openpnp/openpnp-openbuilds/Images/overview_front.jpg

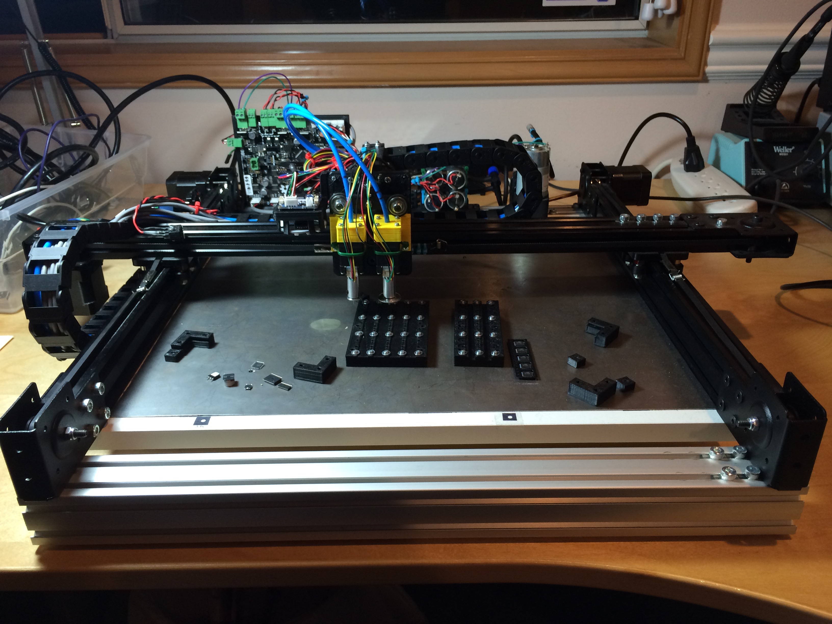
Images/overview_front.jpg
