openpnp/openpnp-openbuilds/Images/overview_top.jpg

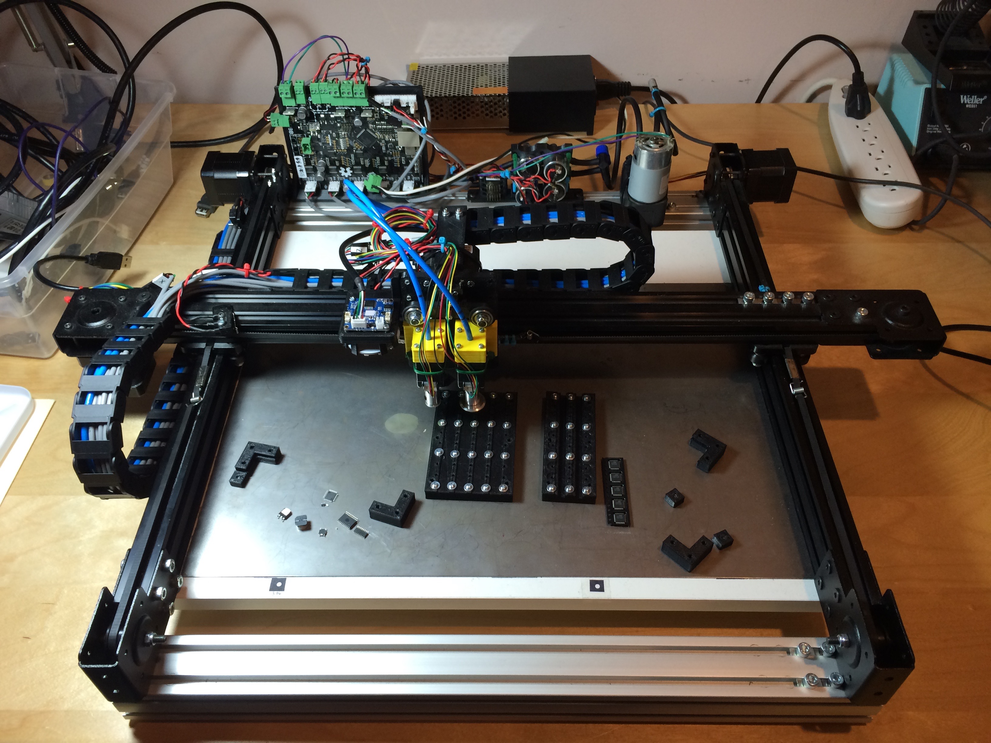
Images/overview_top.jpg
