openpnp/openpnp-openbuilds/Images/camera_closeup.jpg

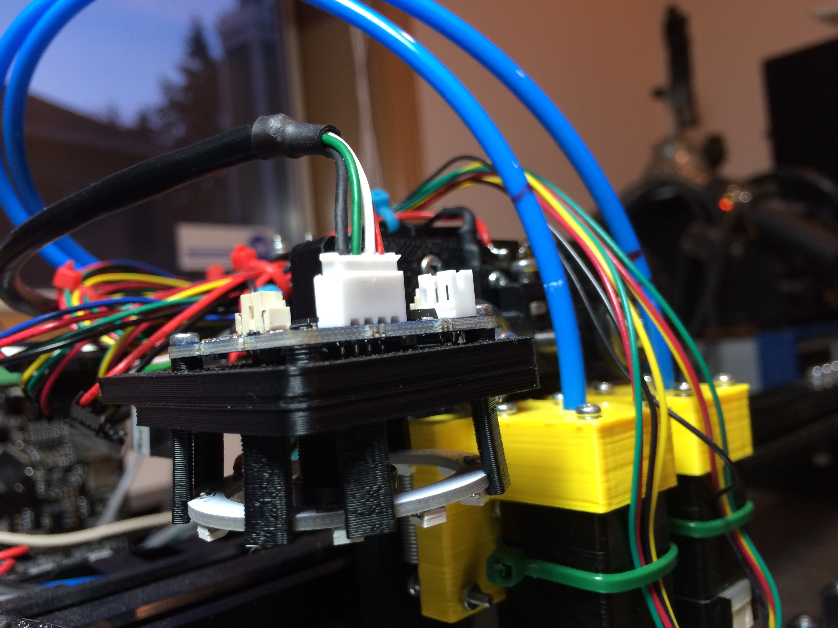
Images/camera_closeup.jpg
