openpnp/openpnp-openbuilds/Images/Electronics and Plumbing.png

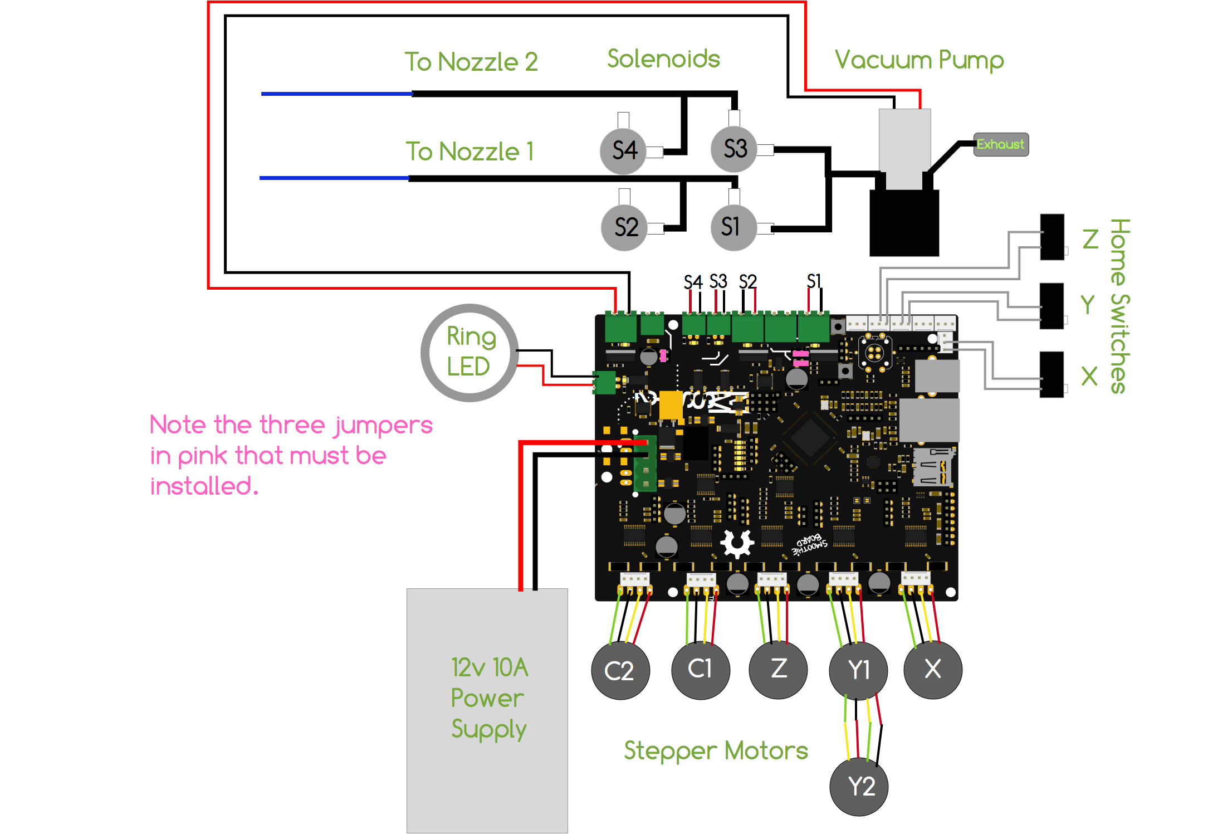
Images/Electronics and Plumbing.png
