openpnp/openpnp-openbuilds/Images/head_closeup.jpg

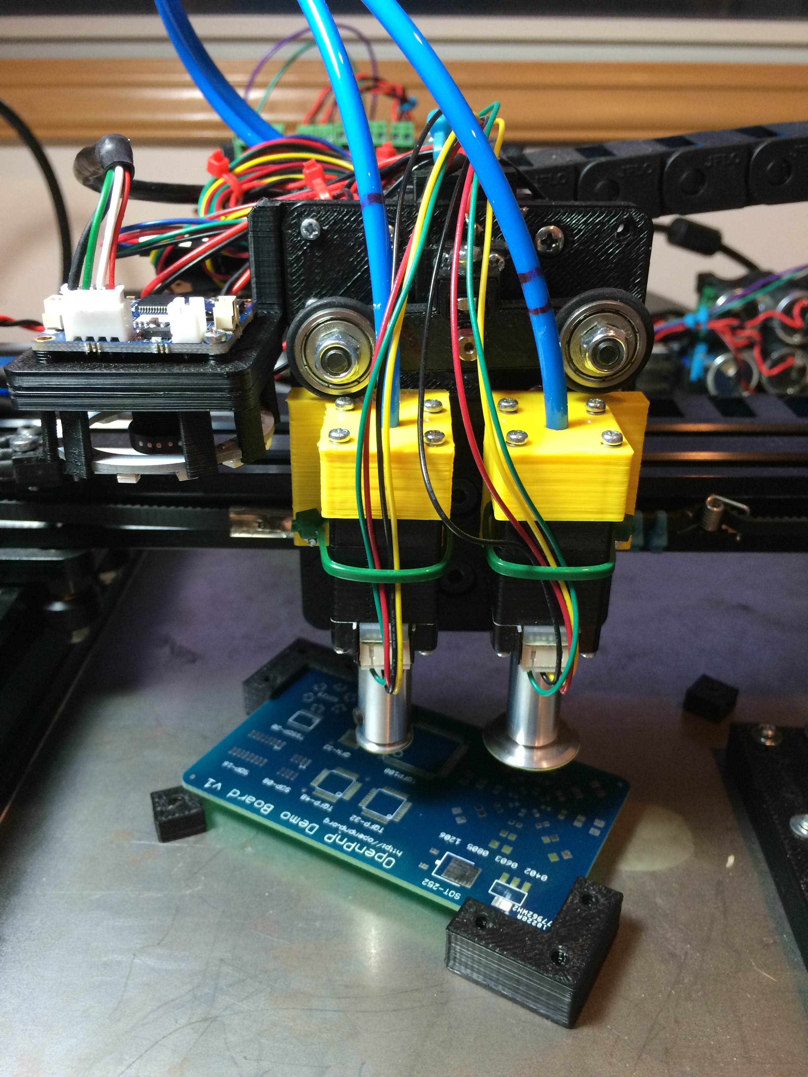
Images/head_closeup.jpg
