openpnp/openpnp-openbuilds/Images/plumbing_detail.jpg

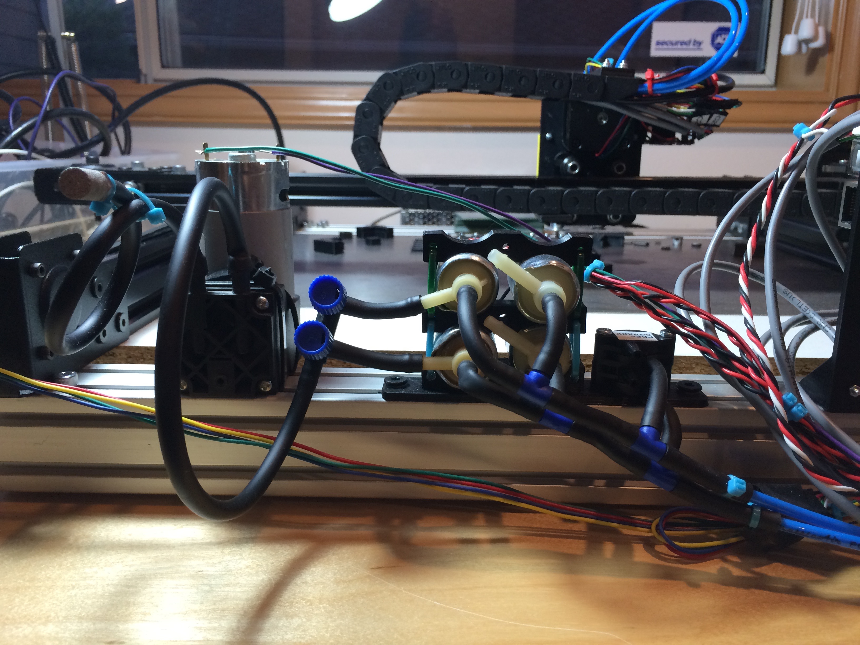
Images/plumbing_detail.jpg
