openpnp/openpnp-openbuilds/Images/pump_diode.jpg

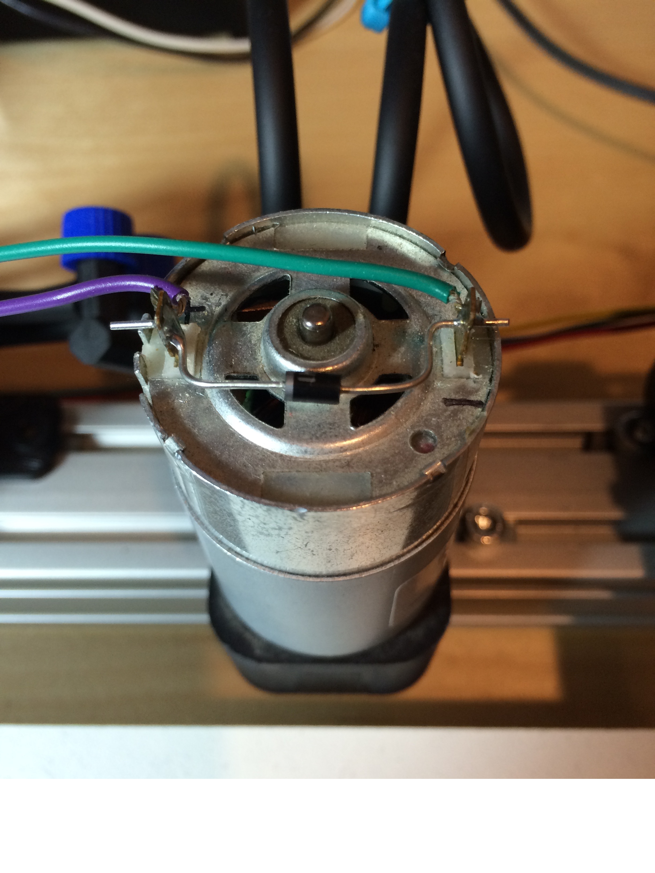
Images/pump_diode.jpg
