openpnp/openpnp-openbuilds/Images/smoothie_jumpers.jpg

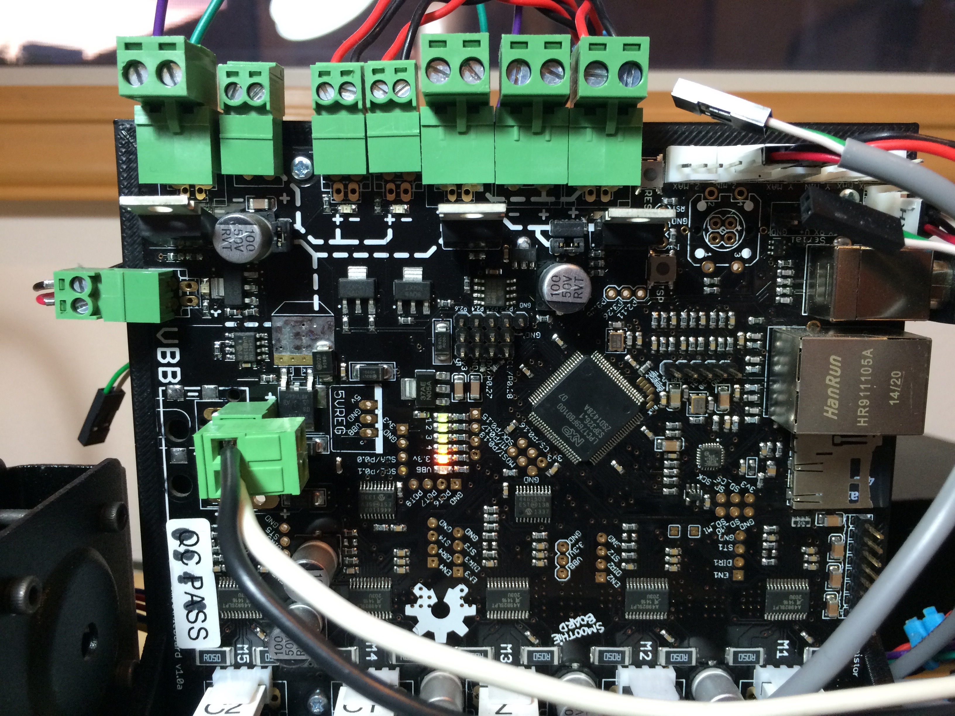
Images/smoothie_jumpers.jpg
