openpnp/openpnp-openbuilds/Images/solenoid_detail.jpg

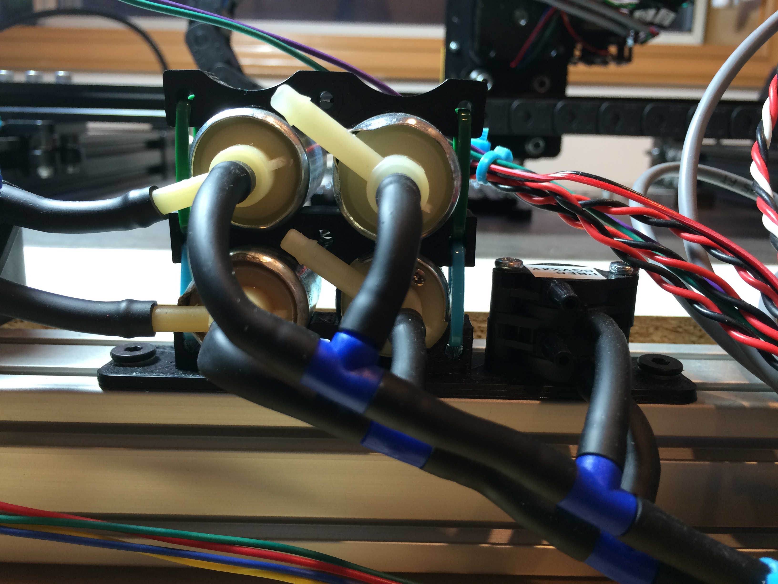
Images/solenoid_detail.jpg
