openpnp/openpnp-openbuilds/Images/solenoid_diodes.jpg

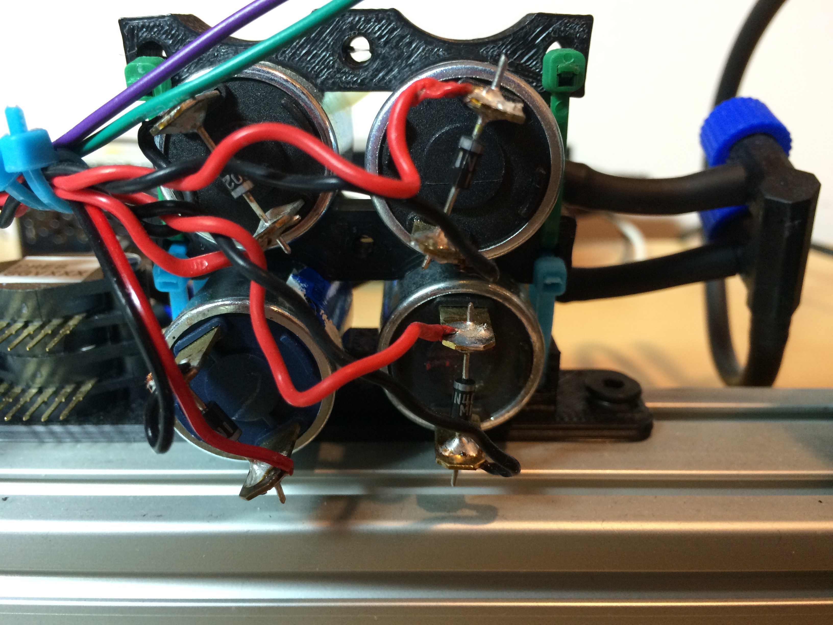
Images/solenoid_diodes.jpg
