openpnp/openpnp-openbuilds/Images/x_y_home_switch_locations.jpg

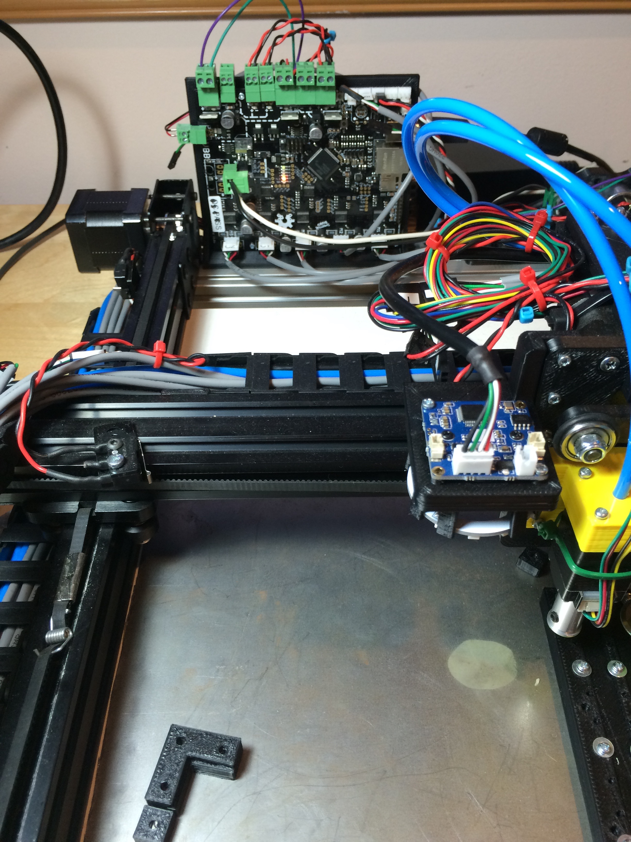
Images/x_y_home_switch_locations.jpg
