openpnp/openpnp-openbuilds/Images/z_detail.jpg

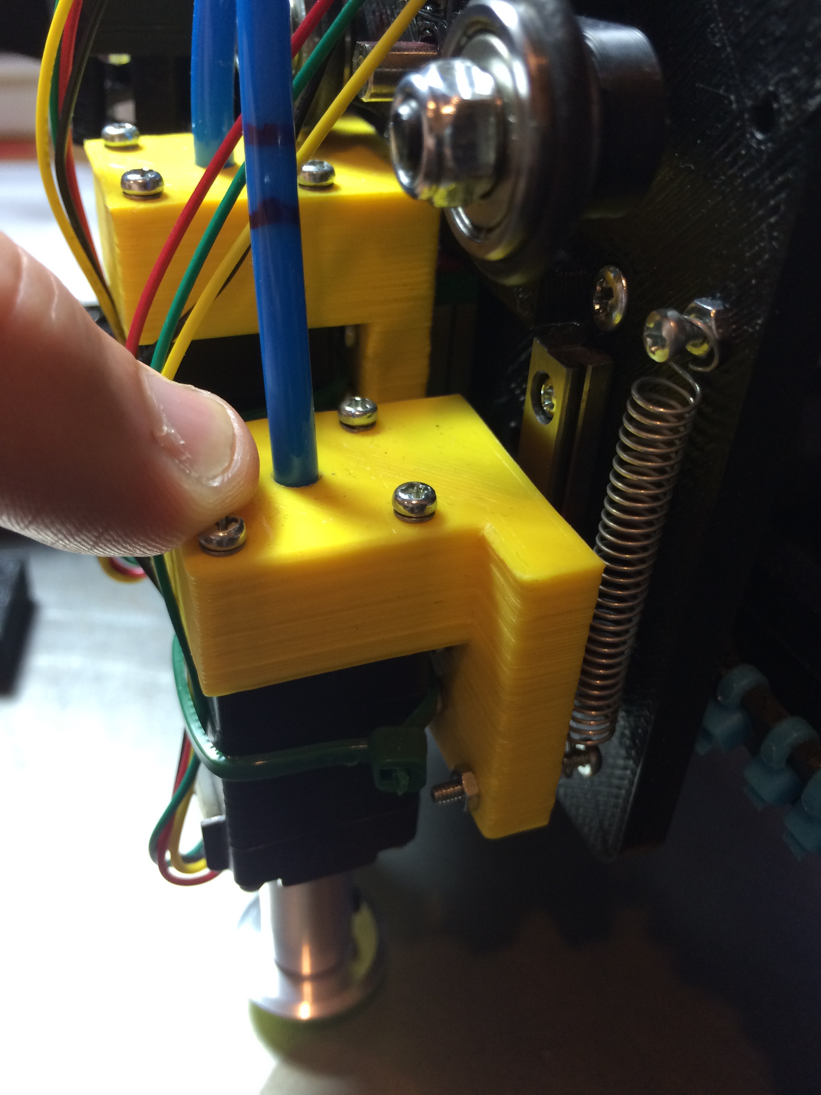
Images/z_detail.jpg
