openpnp/openpnp-openbuilds/Images/z_home_switch_detail.jpg

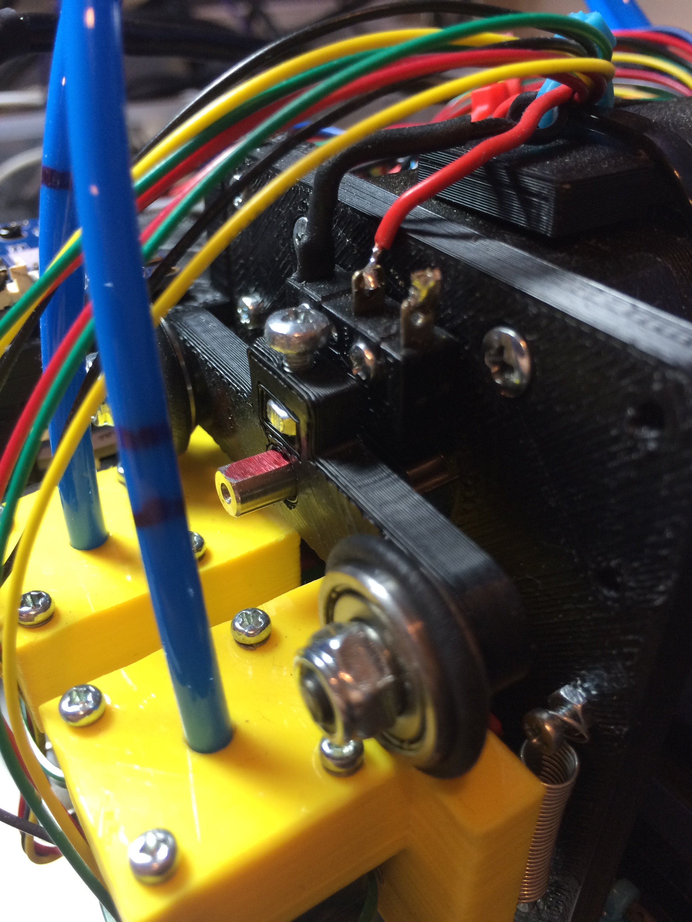
Images/z_home_switch_detail.jpg
