openpnp/openpnp-openbuilds/Mechanical/3D Printed/STL/Reel Holder 7in.stl

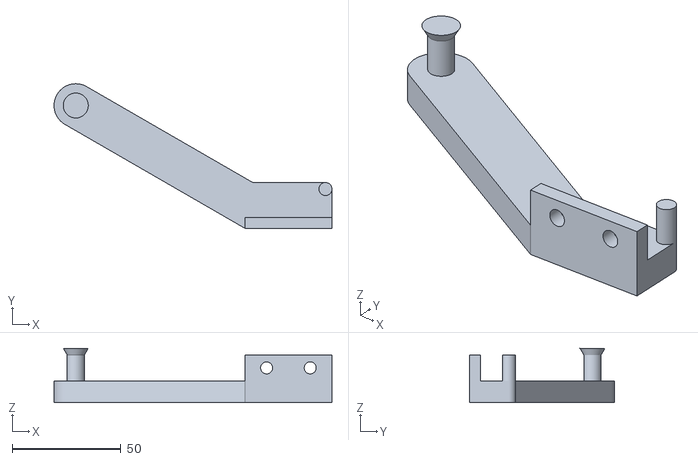
[picture p14: CAD file, 2016-05-17]
Mechanical/3D Printed/STL/Reel Holder 7in.stl
127.6 x 66.3 x 25.0
