openpnp/openpnp-openbuilds/Mechanical/3D Printed/STL/PCB-Holder-Magnetic-L-25mm.stl

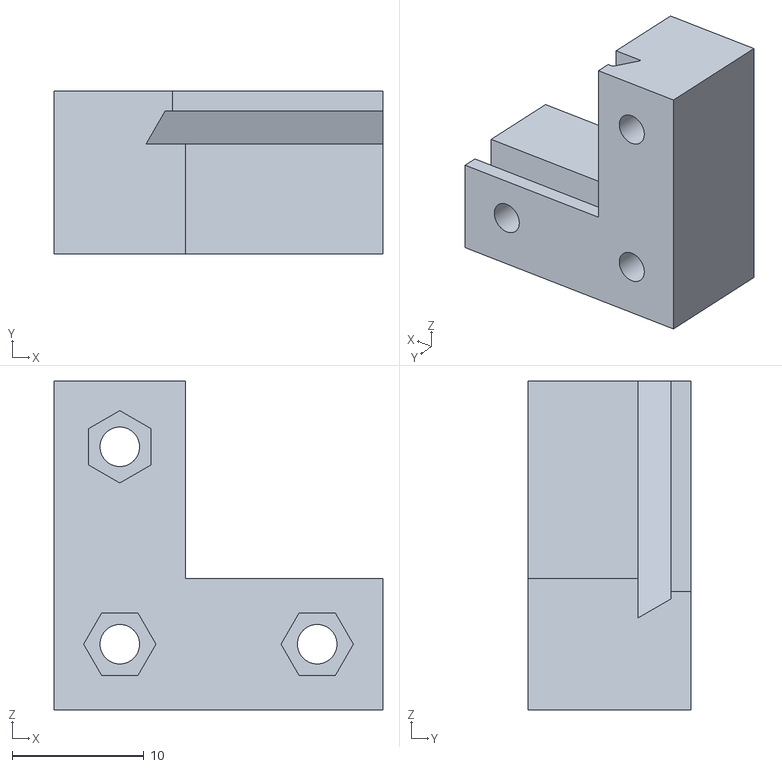
[picture p15: CAD file, 2016-05-17]
Mechanical/3D Printed/STL/PCB-Holder-Magnetic-L-25mm.stl
25.0 x 12.4 x 25.0
