openpnp/openpnp-openbuilds/Mechanical/3D Printed/STL/PCB-Holder-Magnetic-I-20mm.stl

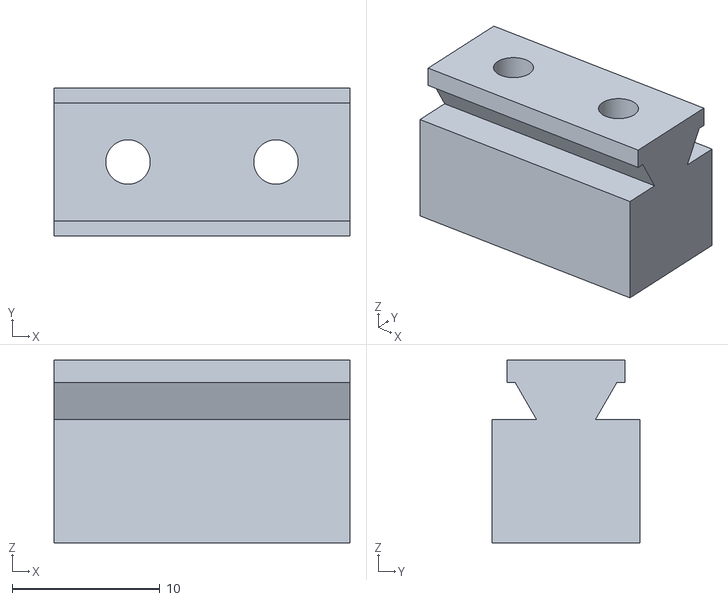
[picture p16: CAD file, 2016-05-17]
Mechanical/3D Printed/STL/PCB-Holder-Magnetic-I-20mm.stl
20.0 x 10.0 x 12.4
