openpnp/openpnp-openbuilds/Mechanical/3D Printed/STL/PCB-Holder-Magnetic-I-40mm.stl

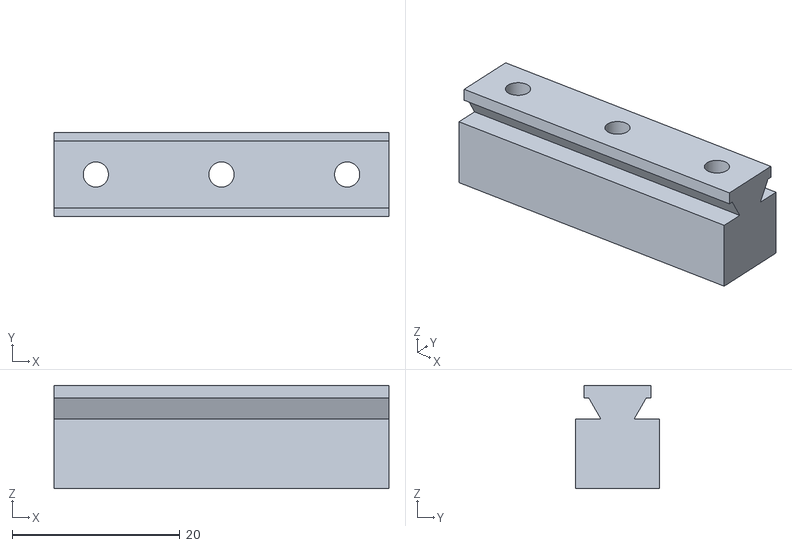
[picture p17: CAD file, 2016-05-17]
Mechanical/3D Printed/STL/PCB-Holder-Magnetic-I-40mm.stl
40.0 x 10.0 x 12.4
