openpnp/openpnp-openbuilds/Mechanical/3D Printed/STL/Feeder-Tape-12mm-Embossed-Body.stl

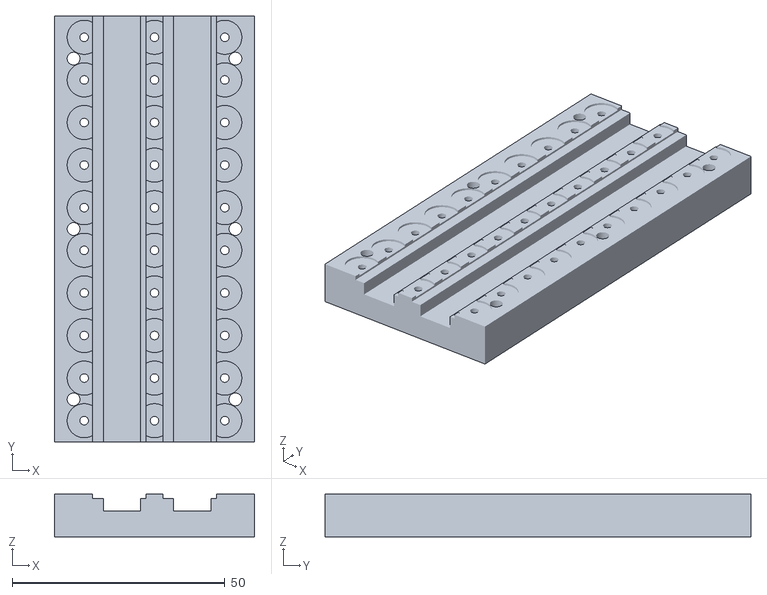
[picture p18: CAD file, 2016-05-17]
Mechanical/3D Printed/STL/Feeder-Tape-12mm-Embossed-Body.stl
47.0 x 100.0 x 10.0
