openpnp/openpnp-openbuilds/Mechanical/3D Printed/STL/Feeder-Tape-16mm-Embossed-Body.stl

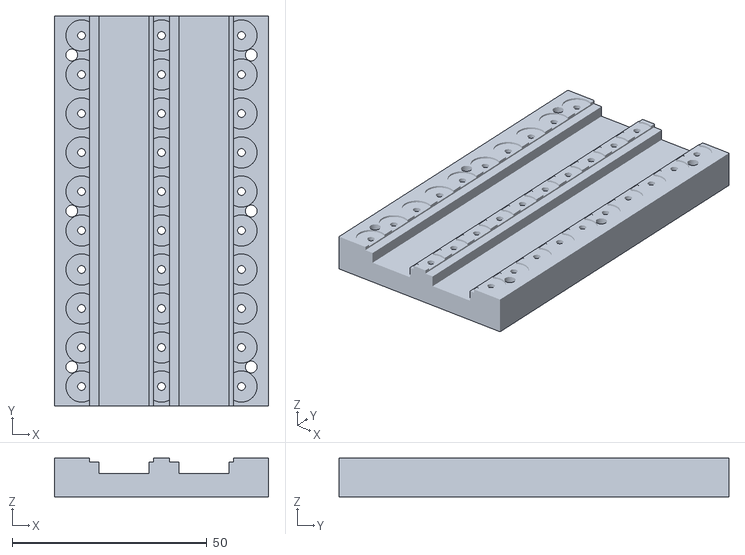
[picture p19: CAD file, 2016-05-17]
Mechanical/3D Printed/STL/Feeder-Tape-16mm-Embossed-Body.stl
55.0 x 100.0 x 10.0
