openpnp/openpnp-openbuilds/Mechanical/3D Printed/STL/PCB-Holder-Magnetic-Support-10mm.stl

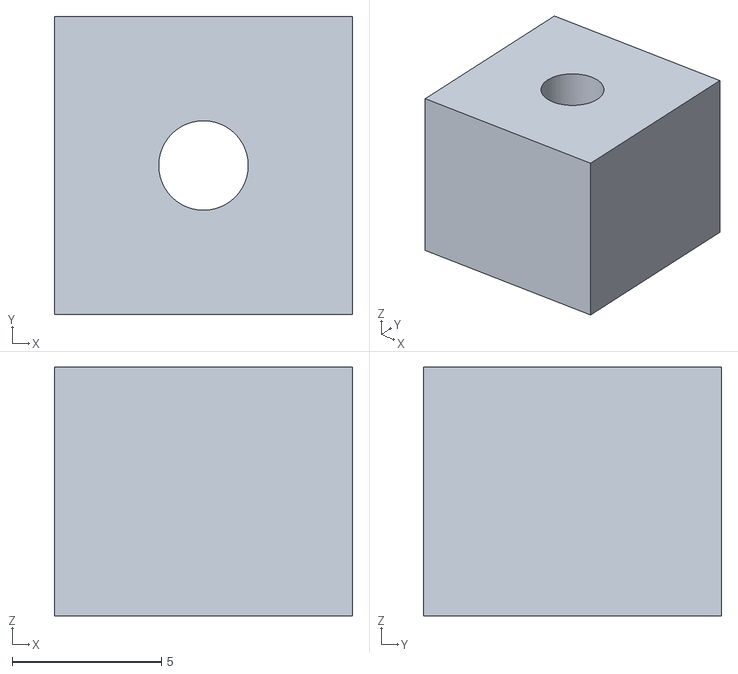
[picture p20: CAD file, 2016-05-17]
Mechanical/3D Printed/STL/PCB-Holder-Magnetic-Support-10mm.stl
10.0 x 10.0 x 8.35
