openpnp/openpnp-openbuilds/Mechanical/3D Printed/STL/Dump Bin - Liner.stl

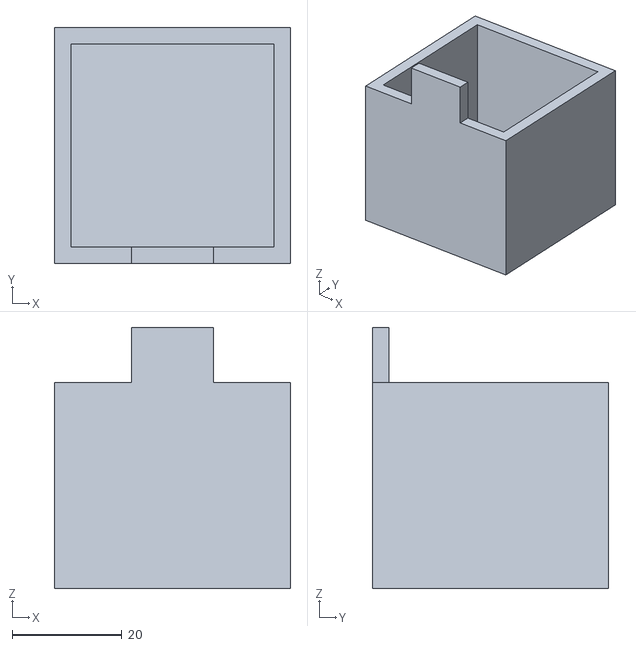
[picture p21: CAD file, 2016-05-11]
Mechanical/3D Printed/STL/Dump Bin - Liner.stl
43.0 x 43.0 x 47.5
