openpnp/openpnp-openbuilds/Mechanical/3D Printed/STL/Dump Bin - Body.stl

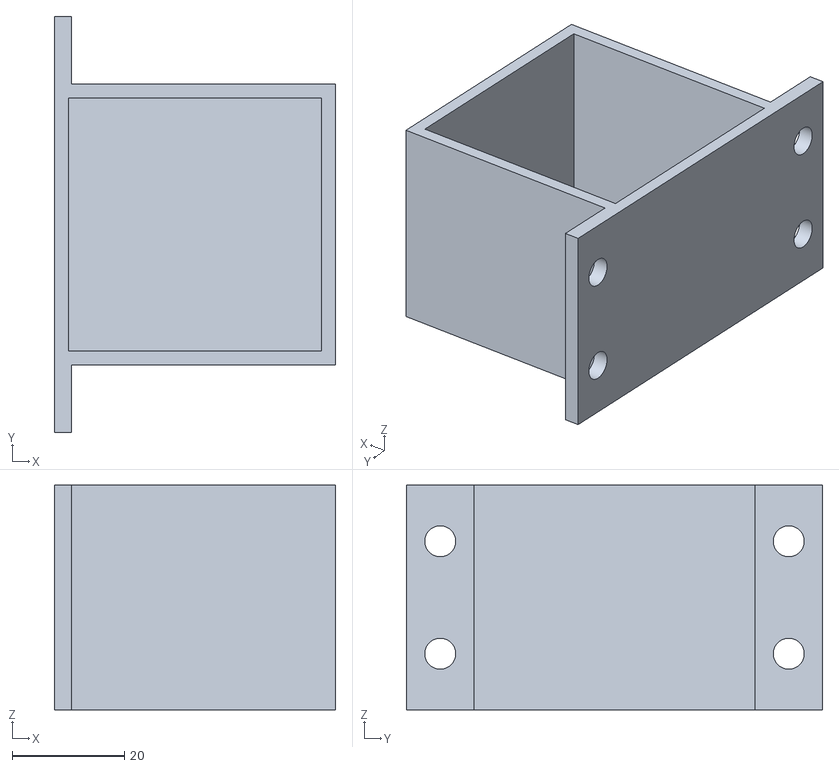
[picture p22: CAD file, 2016-05-11]
Mechanical/3D Printed/STL/Dump Bin - Body.stl
50.0 x 74.0 x 40.0
