openpnp/openpnp-openbuilds/Mechanical/3D Printed/STL/OpenPnP-OpenBuilds-Camera-Mount-Upward-Spacer.stl

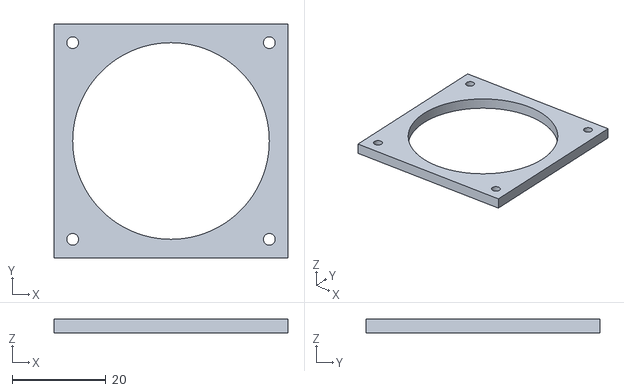
[picture p23: CAD file, 2016-05-11]
Mechanical/3D Printed/STL/OpenPnP-OpenBuilds-Camera-Mount-Upward-Spacer.stl
50.0 x 50.0 x 3.00
