openpnp/openpnp-openbuilds/Mechanical/3D Printed/STL/OpenPnP-OpenBuilds-Camera-Mount-Upward-LED-Mount.stl

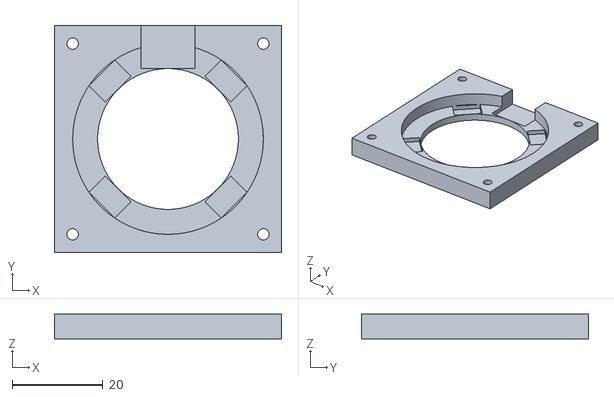
[picture p24: CAD file, 2016-03-11]
Mechanical/3D Printed/STL/OpenPnP-OpenBuilds-Camera-Mount-Upward-LED-Mount.stl
50.0 x 50.0 x 5.50
