openpnp/openpnp-openbuilds/Mechanical/3D Printed/STL/OpenPnP-OpenBuilds-Camera-Mount-Upward-Box.stl

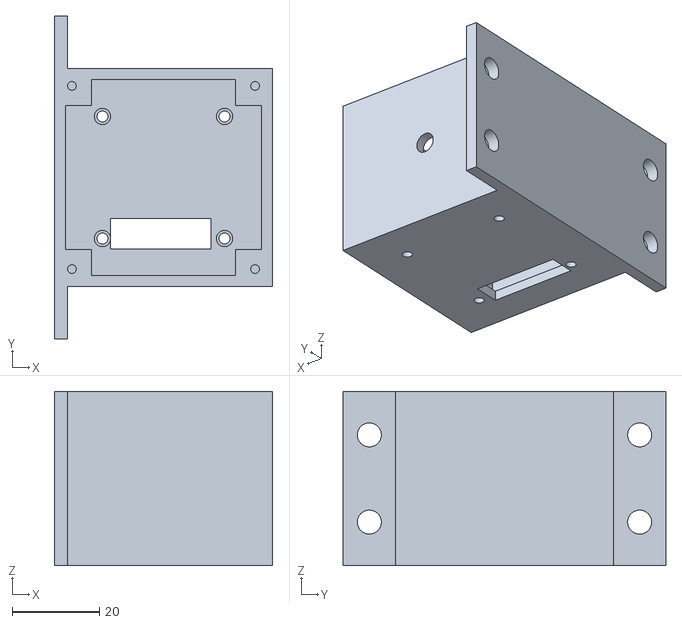
[picture p25: CAD file, 2016-03-11]
Mechanical/3D Printed/STL/OpenPnP-OpenBuilds-Camera-Mount-Upward-Box.stl
50.0 x 74.0 x 40.0
