openpnp/openpnp-openbuilds/Mechanical/3D Printed/STL/Vision Background Disk.stl

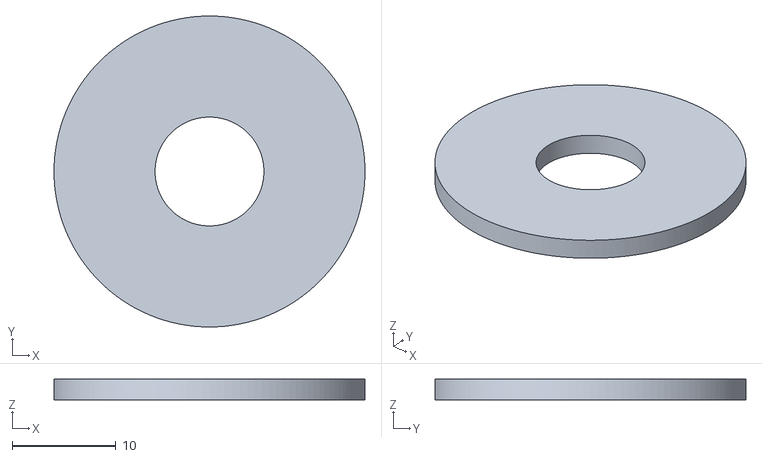
[picture p26: CAD file, 2016-03-11]
Mechanical/3D Printed/STL/Vision Background Disk.stl
30.0 x 30.0 x 2.00
