openpnp/openpnp-openbuilds/Mechanical/3D Printed/STL/Upward Looking Camera.stl

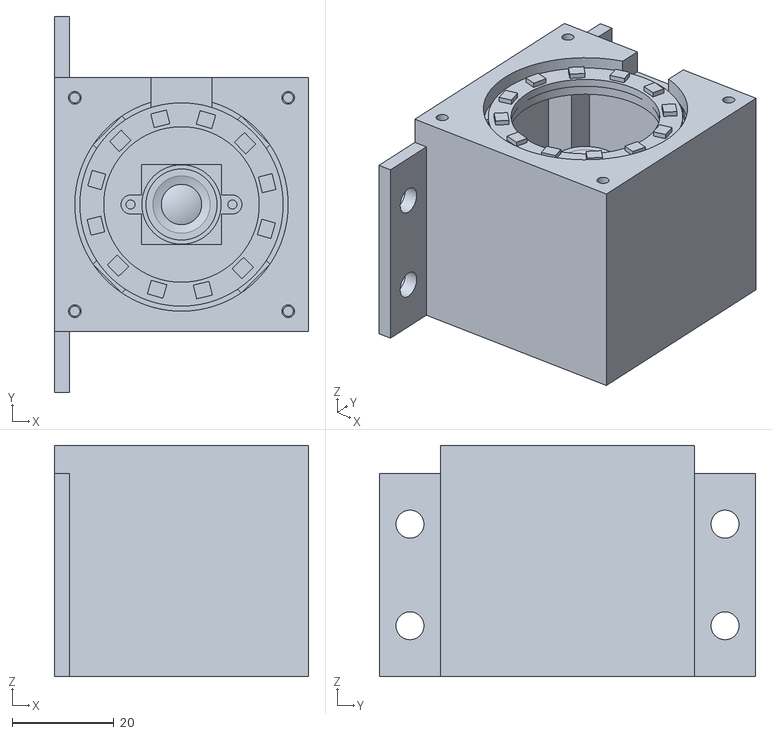
[picture p27: CAD file, 2016-03-11]
Mechanical/3D Printed/STL/Upward Looking Camera.stl
50.0 x 74.0 x 45.5
