openpnp/openpnp-openbuilds/Mechanical/3D Printed/STL/Valves and Sensors Middle.stl

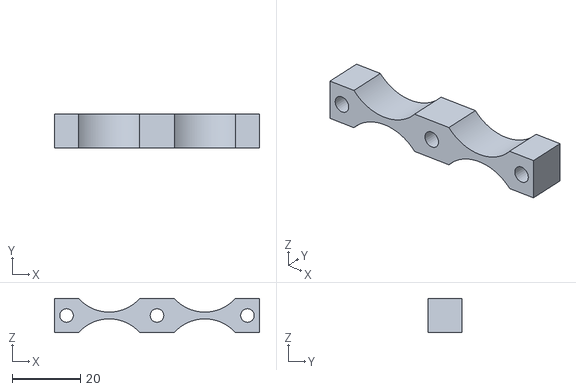
[picture p28: CAD file, 2015-05-12]
Mechanical/3D Printed/STL/Valves and Sensors Middle.stl
60.0 x 10.0 x 10.0
