openpnp/openpnp-openbuilds/Mechanical/3D Printed/STL/OpenPnP-OpenBuilds-Z-Cam.stl

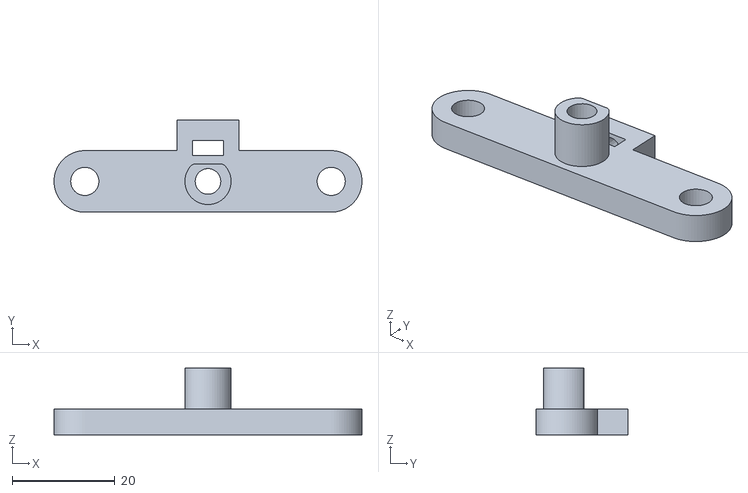
[picture p29: CAD file, 2015-05-12]
Mechanical/3D Printed/STL/OpenPnP-OpenBuilds-Z-Cam.stl
60.0 x 18.0 x 13.0
