openpnp/openpnp-openbuilds/Mechanical/3D Printed/STL/Cable Carrier 10x20 Connector Female.stl

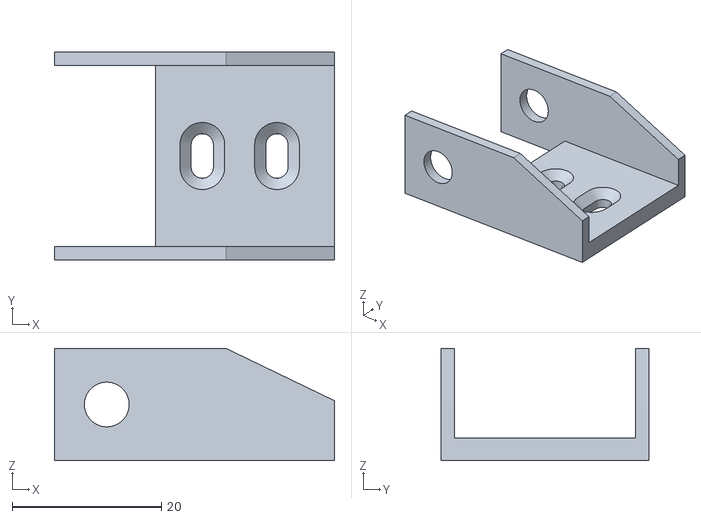
[picture p30: CAD file, 2015-05-12]
Mechanical/3D Printed/STL/Cable Carrier 10x20 Connector Female.stl
37.5 x 27.8 x 15.0
