openpnp/openpnp-openbuilds/Mechanical/3D Printed/STL/Cable Carrier 10x20 Connector Male.stl

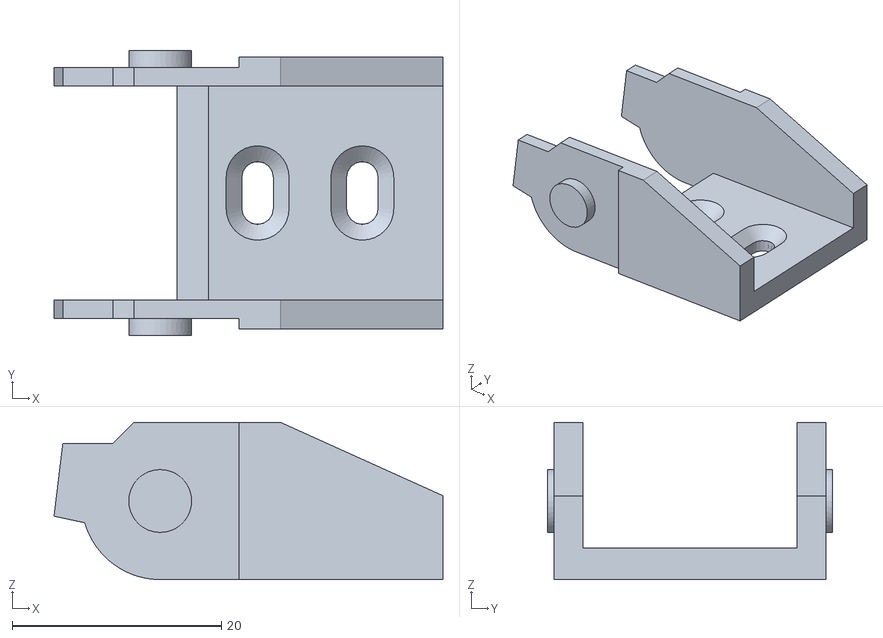
[picture p31: CAD file, 2015-05-12]
Mechanical/3D Printed/STL/Cable Carrier 10x20 Connector Male.stl
37.1 x 27.2 x 15.0
