openpnp/openpnp-openbuilds/Mechanical/3D Printed/STL/Valves and Sensors Mount - Base.stl

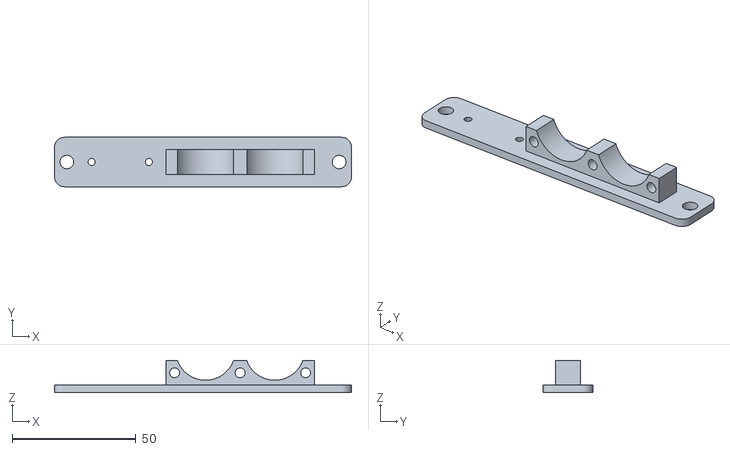
[picture p32: CAD file, 2015-05-12]
Mechanical/3D Printed/STL/Valves and Sensors Mount - Base.stl
120.0 x 20.0 x 13.0
