openpnp/openpnp-openbuilds/Mechanical/3D Printed/STL/Cable Carrier Bracket 10x20 Straight.stl

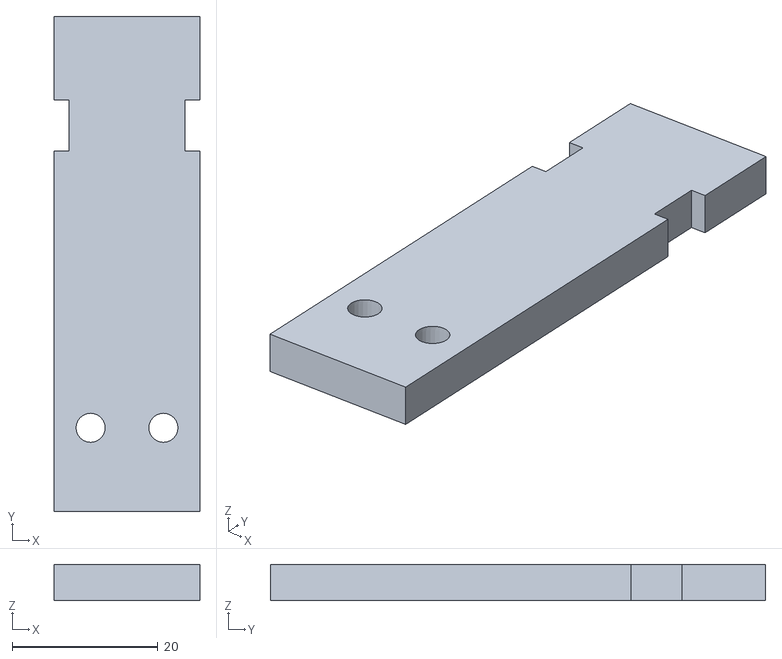
[picture p33: CAD file, 2015-05-12]
Mechanical/3D Printed/STL/Cable Carrier Bracket 10x20 Straight.stl
20.0 x 68.0 x 5.00
