openpnp/openpnp-openbuilds/Mechanical/3D Printed/STL/LED-Ring-Mount-40mm.stl

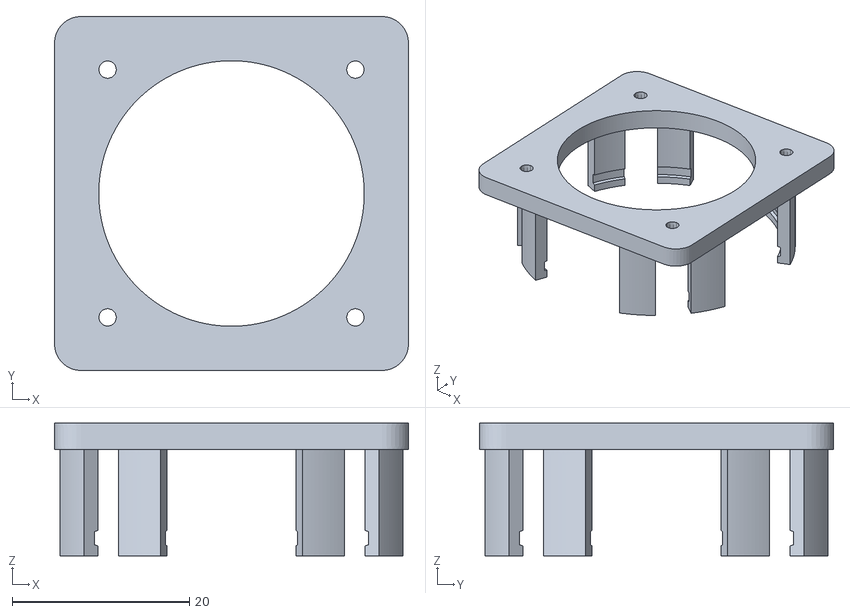
[picture p34: CAD file, 2015-05-12]
Mechanical/3D Printed/STL/LED-Ring-Mount-40mm.stl
40.0 x 40.0 x 15.0
