openpnp/openpnp-openbuilds/Mechanical/3D Printed/STL/Cable Carrier Bracket 10x20 L.stl

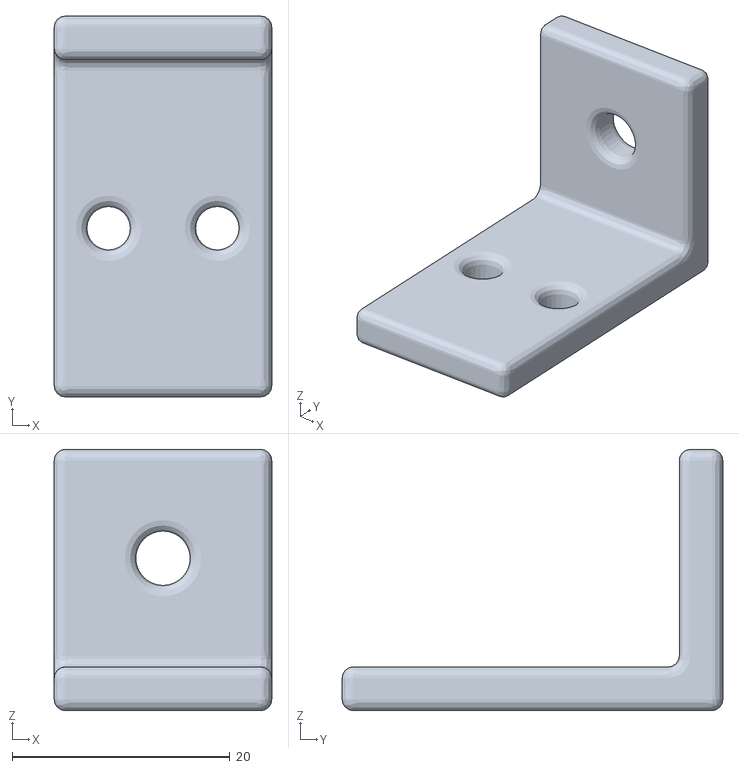
[picture p35: CAD file, 2015-05-12]
Mechanical/3D Printed/STL/Cable Carrier Bracket 10x20 L.stl
20.0 x 35.0 x 24.0
