openpnp/openpnp-openbuilds/Mechanical/3D Printed/STL/NeoPixel-12-Mount.stl

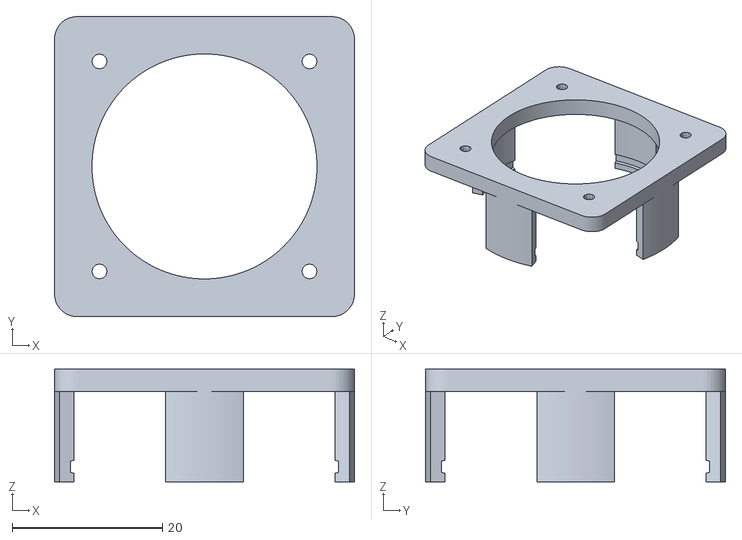
[picture p36: CAD file, 2015-02-27]
Mechanical/3D Printed/STL/NeoPixel-12-Mount.stl
40.0 x 40.0 x 15.0
