openpnp/openpnp-openbuilds/Mechanical/3D Printed/STL/OpenPnP-OpenBuilds-C-Mount-Right.stl

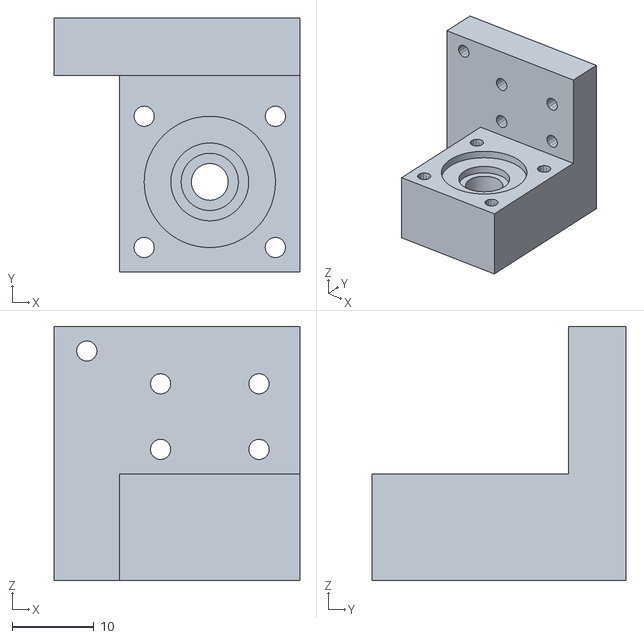
[picture p37: CAD file, 2015-01-04]
Mechanical/3D Printed/STL/OpenPnP-OpenBuilds-C-Mount-Right.stl
30.0 x 31.0 x 31.0
