openpnp/openpnp-openbuilds/Mechanical/3D Printed/STL/OpenPnP-Mini-PCB-Holder-2-Piece.stl

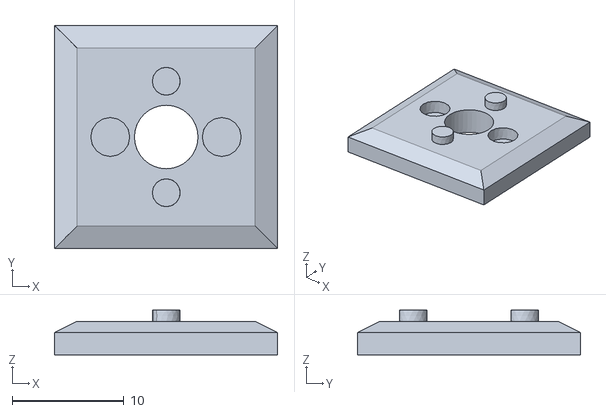
[picture p38: CAD file, 2015-01-02]
Mechanical/3D Printed/STL/OpenPnP-Mini-PCB-Holder-2-Piece.stl
20.0 x 20.0 x 4.00
