openpnp/openpnp-openbuilds/Mechanical/3D Printed/STL/OpenPnP-OpenBuilds-Camera-Mount.stl

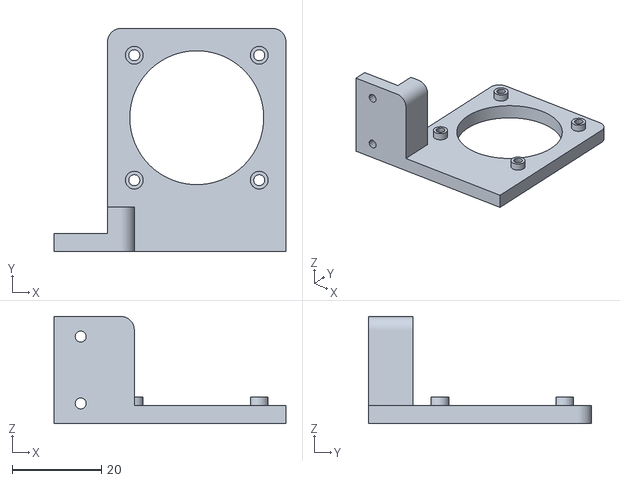
[picture p39: CAD file, 2014-12-29]
Mechanical/3D Printed/STL/OpenPnP-OpenBuilds-Camera-Mount.stl
52.0 x 50.0 x 24.0
