openpnp/openpnp-openbuilds/(list of files, cad)

Other CAD files:
Mechanical/3D Printed/STL/OpenPnP-OpenBuilds-C-Mount.stl
