openpnp/openpnp-openbuilds/(threads)

Thread 1 (2015-05-26):

Camera holder / LED ring holder denies access to lens adjustment screw

vonnieda, 2015-05-26:
The LED ring blocks access to lens focus adjustment screw. Either the camera holder or LED ring holder should be modified to allow a small screwdriver access to the screw.

Thread 2 (2015-05-26):

First solenoid tubing gets crimped at bend, replace with elbow.

vonnieda, 2015-05-26:
The solenoid tubing has a 90 degree bend from the first solenoid to the first tee and this causes the tubing to collapse. Replace it with an elbow.

Thread 3 (2015-06-23):

Document Head Build

vonnieda, 2015-06-23:
Tear apart the prototype head and better document it. Since many of the screws are hidden or hard to get to they should be documented better. This can be done BOM style or in the 3D models.

Thread 4 (2015-06-23):

Juki Nozzle Adapter

vonnieda, 2015-06-23:
Juki nozzles are cheap and plentiful, they come in many sizes, and have spring loaded tips. They look like a good general solution, but we need a nozzle adapter.

The shaft of the nozzle is 7mm and it has a slot for a detent. I suspect we can design a nozzle adapter that has 3-4 spring loaded ball bearings to hold the nozzle in and make it auto changeable.

In addition, when the spring loaded tip is about 3/4 depressed, the top of it's shaft extends above the top of the shaft of the nozzle. I think this can be used as a z-probe either by having it touch a metal contact or sensing it optically or with hall effect.

The nozzles can be found on Aliexpress, such as:

http://www.aliexpress.com/snapshot/6621444175.html?orderId=66890678761344

Thread 5 (2016-05-24):

Please consider using Fusion 360 for CAD

JetForMe, 2016-05-24:
It's free and fully-functional, competitive with something like SolidWorks, and runs on both Mac and Windows. Thanks!

vonnieda, 2016-05-25:
@JetForMe The next machine design will most likely use Fusion 360, but IMHO it's not worth doing all the conversion required to convert this one. Someone would need to go through and convert all the files, rebuild all the assemblies, create the constraints, etc.

JetForMe, 2016-05-25:
Yeah, I understand. Sadly, I don't have Windows to use Cubify. Any chance you could export the files as STEP (or IGES)?

I can probably make do with the .stl files, or maybe I'll just design my head from scratch.

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

vonnieda, 2016-05-25:
Unfortunately Cubify doesn't allow export of any useful file format, such
as STEP or IGES. That's one of the reasons this is such a problem. Hooray
for vendor lock in!

That being said, you can download free Windows VMs from here
https://developer.microsoft.com/en-us/microsoft-edge/tools/vms/mac/

These run well in VMWare, VirtualBox, Parallels, etc. and combined with the
14 day free trial of Cubify that might be enough to get you going.

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

JetForMe, 2016-05-25:
And I have to get a copy of Windows…it's all very tedious.

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

--
Rick Mann
rmann@latencyzero.com

vonnieda, 2016-05-25:
Check that link in my previous message. They are free Windows VMs that run
out of the box. Just download, fire up your preferred VM host and you are
up and running with zero dollars spent. It's a pain, I agree, but when I
started this project Cubify was really the only reasonable option and now
I'm somewhat locked in with it.

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

JetForMe, 2016-05-25:
No worries! I'll see how I get along, and if the pain gets high enough, I'll give it a shot.

What about dimensioned PDF files? I imagine that's a pain, too.

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

--
Rick Mann
rmann@latencyzero.com

vonnieda, 2016-05-25:
Cubify does let you make dimensioned drawings, but someone will have to do
all the work, and it's probably about as much work as just redrawing them
in Fusion. I'm happy to leave this issue open to see if someone is willing.

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

Kenzu, 2023-12-14:
Hi

I know this is a old issue, but landed here via a Cubify google search. Just wanna tell that Cubify is based on Alibre Design/Atom, so it is possible to open all files in Alibre Design/Atom.
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

https://www.alibre.com

Don't know if this is of any use.

Jesper

vonnieda, 2023-12-14:
Hi @Kenzu  - thanks for posting this! I had noticed that Alibre was making some kind of comeback, and I was wondering if the files would still work. I'm happy to see they do!

Thread 6 (2016-06-11):

Cameras?

JetForMe, 2016-06-11:
Hi. In the BOM I see the "head camera," but I don't see the other camera (the one it holds parts over for identification and positioning). Is it a second of the same camera and lens?

Thanks.

vonnieda, 2016-06-11:
Hi @JetForMe, the current stable build (the master branch) does not include the bottom vision camera. I have not yet done an official release of the version of the machine that includes it since several other parts have changed. Here's the current status of things:

Develop Branch:
* Z plate size increased to accommodate taller nozzle adapters.
* Z home switch removed, homing is done by by the springs now.
* Juki nozzle adapters and nozzles added.
* Bottom vision camera added.
* Hardware shown at Maker Faire 2016.
* BOM has not been updated yet.

Master Branch:
* Current stable release.
* Shown at Maker Faire 2015.

The primary change between the two is the change from Fuji CP-6 nozzles to Juki nozzles. This required a change to the Z plate, moving everything up. I have not yet decided if I feel like this is good enough for release, and the parts are more difficult to source, so I haven't made it official yet. The biggest issue is that the Juki nozzle adapters I am using were custom made. There is a community member who has just sourced a version of these, so if they prove to be compatible I will recommend those as the source and update the Develop branch to the Master branch.

JetForMe, 2016-06-11:
Oh, interesting. How do you properly rotate parts without the bottom camera?

JetForMe, 2016-06-11:
Also, sorry. What camera is used for the bottom? I don't see a BOM in the github repo, just on Google drive. Same camera/lens as the head?

vonnieda, 2016-06-11:
Rotation is just handled blindly. It works well for 0805s and above, and 0.8mm pitch ICs and above. As you get smaller you really need the bottom vision to improve accuracy.

The camera is the same camera, different lens. I believe I'm using a 3.2mm fisheye at the moment. I can't quite tell because it's inside the box, but I will check next time I take the lid off.

It has a lot to do with how you build the frame and where you mount the camera. It's just a matter of being able to get the part above the camera and in focus.

When I release the new version I'll archive the current BOM and update it with the new parts, including the camera and lens. Aside from that the only other change to the BOM is the use of a different, quieter vacuum pump. I'm using this one now: http://www.robotdigg.com/product/599/Diaphragm+pump+4+desktop+PNP+Machine

JetForMe, 2016-06-11:
Awesome, thanks!

Closed 2016-06-11.

Thread 8 (2017-07-25):

Cable chain quantity inside BOM

pierre-x, 2017-07-25:
In the bill of materials, the cable chain quantity is 1. It should be 2.

vonnieda, 2017-08-02:
Thanks, updated!

Closed 2017-08-02.

Thread 9 (2017-09-08):

BOM update

byrek, 2017-09-08:
Howdy,
I have just received a mechanical set from OpenBuilds store. Parts were ordered using BOM list. There are some issues that may be updated:
- row 5 (M5x10 Low Profile SCHS) are way too long, they should be M5x6 Low Profile SCHS with a following link http://openbuildspartstore.com/low-profile-screws-m5-30-pack/
- row 22, 44, 69 (M5x30 Low Profile SCHS) are too short, they should be at least 32mm to catch the thread,so 35mm is fine; link http://openbuildspartstore.com/low-profile-screws-m5/
I will keep You updated, brgds, Mike

vonnieda, 2017-09-14:
Thanks Mike, appreciate the updates! I've updated the BOM.

Closed 2017-09-14.

Thread 10 (2020-09-18):

Configuration

fdixonb, 2020-09-18:
Following the steps for Configuration at the end of this webpage gives an error, after downloading and saving the machine.xml file to the .openpnp2 directory
https://github.com/openpnp/openpnp-openbuilds/wiki/Build-Instructions

Configuration load error.  Element nozzle-tips does not have a match in ...

The xml file looks fine to me so not sure if this is an openpnp issue or not.

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

vonnieda, 2020-09-27:
The config posted there has become outdated and is no longer compatible with the current code. I'd recommend just following the configuration guide at https://github.com/openpnp/openpnp/wiki/Setup-and-Calibration instead, and you can use the old config as a reference if needed.

Closed 2020-09-27.
