openpnp/openpnp-openbuilds/(commit log)

2014-10-11 Rearranged the hardware directory a bit.
    [OpenPnP - OpenBuilds - BOM.xlsx, OpenPnP-OpenBuilds-C-Mount.stl, OpenPnP-OpenBuilds-Z-Cam.stl, OpenPnP-OpenBuilds-Z-Plate.stl]
2014-10-28 Minor updates to TinyG Driver.
2014-11-30 Reduced depth of z-plate Fixed up screw holes
2014-12-24 Lots of work on head and nozzle assemblies. Started putting together the frame.
    [OpenPnP-OpenBuilds-C-Mount.stl, OpenPnP-OpenBuilds-Z-Cam.stl]
2014-12-29 Working version of the kit.
    [OpenPnP-OpenBuilds-C-Mount.stl, OpenPnP-OpenBuilds-Camera-Mount.stl]
2014-12-29 Converted to Cubify.
    [OpenPnP-OpenBuilds.skp]
2015-01-02 Periodic checkpoint.
    [OpenPnP-Mini-PCB-Holder-2-Piece.stl]
2015-02-20 Added a home switch to the Z plate. Added a top endstop for the Z axes to the Z plate. Updated the cam to include a flat on the shaft extension for triggering the home switch.
    [OpenPnP-OpenBuilds-Z-Cam.stl]
2015-02-27 Checkpoint after first successful run.
    [NeoPixel-12-Mount.stl]
2015-03-12 Some PCB holders. Use 3/16" x 3/16" rod magnets and push them in with channel locks.
    [PCB-Holder-Magnetic-I-40mm.stl, PCB-Holder-Magnetic-L-25mm.stl]
2015-03-17 Lots of work on 3D parts. Added a series of magnetic PCB holders. Started work on a 8mm tape drag feeder. Added a Smoothieboard mount. Added a power supply cover.
    [PCB-Holder-Magnetic-I-20mm.stl, PCB-Holder-Magnetic-Support-10mm.stl]
2015-03-23 Adds a few cable carrier brackets. These are mostly throw away, but are working for now. Based on 15x10mm cable carrier. Increased wall length of camera mount to clear cam. This might get undone in f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
    [Cable Carrier Bracket 20x23mm.stl, Cable Carrier Bracket 60mm.stl, LED-Ring-Mount-40mm.stl]
2015-05-12 Just checking in all the work that's been done over the past few weeks. Represents current state of the machine.
    [Air Equipment Holder.stl, Cable Carrier 10x20 Connector Female.stl, Cable Carrier 10x20 Connector Male.stl, Cable Carrier Bracket 10x20 L.stl, Cable Carrier Bracket 10x20 Straight.stl, Cable Carrier Bracket 20x23mm.stl, Cable Carrier Bracket 60mm.stl, LED-Ring-Mount-40mm.stl]
2015-05-21 Current machine.xml as of Maker Faire 2015.
2015-12-14 Add the Juki nozzle and adapter and update the left nozzle assembly to use it.
2015-12-14 Extend the z plate to give correct clearance for the juki nozzle.
2015-12-18 Finish up Juki nozzle Update head to use Juki nozzles and adapaters Move Z endstops and rails up 2mm so Z rests against the Z cam Eliminate the Z home switch
2015-12-19 Minor adjustments to Z plate to better align endstop with the cam center. Updated o-ring to be the correct size after placement on v-groove bearing.
2016-01-02 Remove the drag solenoid as this was never actually finished and it's confusing for people.
2016-01-18 Added missing STL for valve mount base.
    [Valves and Sensors Mount - Base.stl]
2016-02-01 Start working on upward looking camera mount. Update ELP camera to include proper sizes for connectors. Add OpenBuilds bed.
2016-02-10 Added a hole to show where the lens set screw goes in the camera module.
2016-03-11 Work on upward looking camera mount.
    [OpenPnP-OpenBuilds-Camera-Mount-Upward-Box.stl, OpenPnP-OpenBuilds-Camera-Mount-Upward-LED-Mount.stl, Upward Looking Camera.stl, Vision Background Disk.stl]
2016-05-11 Added a spacer for a diffusion filter on top of the upward looking camera. Should really be integrated into the lid but didn't want to reprint the lid. Add STLs for all new parts.
    [Dump Bin - Body.stl, Dump Bin - Liner.stl, OpenPnP-OpenBuilds-Camera-Mount-Upward-Spacer.stl]
2016-05-13 Added a preliminary reel holder for 7" reels. Probably needs another iteration with something to keep the tape from pulling out at too high of an angle.
    [Reel Holder 7in.stl]
2016-05-17 Added a tape guide to the reel holder to keep the tape down at the bed level. Added 12 and 16mm versions of the embossed strip holder. Reworked board holders to place the top of the PCB at the same h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
    [Feeder-Tape-12mm-Embossed-Body.stl, Feeder-Tape-16mm-Embossed-Body.stl, PCB-Holder-Magnetic-I-20mm.stl, PCB-Holder-Magnetic-I-40mm.stl, PCB-Holder-Magnetic-L-25mm.stl, PCB-Holder-Magnetic-Support-10mm.stl, Reel Holder 7in.stl]
